EricGend/smart-scale/Dokumentation_Latex/Dateien/Allgemein/Titelseite_Praxisbericht.tex

\newgeometry{left=2.5cm, right=2.5cm, top=2.5cm, bottom=2.5cm}

\begin{titlepage}

\begin{center}


\begin{Large}
	Hochschule für angewandte Wissenschaften Coburg\\
	Fakultät Elektrotechnik und Informatik
	\par
\end{Large}

\vspace{1.5cm}
        
\begin{Large}
	Studiengang: \Studiengang
\par
\end{Large}

\vspace{1.5cm}
        
\begin{Large}
	\Dokumententitel
	
	Betreut durch: \Betreuer
\end{Large}

\vspace{1cm}
        
\begin{huge}
	\Autorenname
\end{huge}

\vspace{1.5cm}   

%\begin{table}[hp]
%	\centering
%	\begin{tabular}{| L{3cm} | L{11cm} |}
%	\hline
%	Unternehmen & \UnternehmenName \\
%	& \UnternehmenAbteilung \\
%	& \UnternehmenStrasse \\
 %	& \UnternehmenOrt \\
%	\hline
%	Zeitraum & \DatumBeginn \ bis \DatumEnde \\
%	\hline
%	\end{tabular}
%\end{table}

\begin{large}
	Abgabe des Berichts: \Abgabedatum
\end{large}

%\begin{table}[hp]
%	\centering
%	\begin{tabular}{| L{3cm} | L{6cm} | L{5cm} |%}
%	\multicolumn{3}{l}{Freigabe zur Vorlage des Praxisberichts an der HS Coburg:} \\
%	\hline
%	Betreuer & \UnternehmenBetreuer & \\
%	\hline
%	Funktion & \BetreuerFunktion & \textbf{\textit{Ort, Datum}}\\
%	\hline
%	Telefon	& \BetreuerTelefon & \\
%	\cline{1-2}
%	email & \BetreuerEmail & \\
%	\hline
 %	& & \textbf{\textit{Unterschrift Betreuer}}\\
%	\hline
%	\end{tabular}
%\end{table}
        
\end{center}
    
\end{titlepage}

\restoregeometry
