EricGend/smart-scale/Dokumentation_Latex/Dateien/Allgemein/ehrenwoertliche_Erklaerung.tex

\section*{Ehrenwörtliche Erklärung}

\begin{verbatim}

\end{verbatim}

Ich versichere hiermit, dass ich meine \Dokumentenart \ selbstständig verfasst, keine anderen als die angegebenen Quellen und Hilfsmittel benutzt, sowie nicht an anderer Stelle als Prüfungsarbeit vorgelegt habe.

\begin{verbatim}

\end{verbatim}

\begin{table*}[hp]
\centering
\begin{tabular}{ L{6cm} L{2cm} L{6cm}}
& & \\
& & \\ \cline{1-1}
Ort &  \\
& & \\
& & \\
& & \\
& &  \\ \cline{1-1} \cline{3-3}
Datum & & Unterschrift \\
\end{tabular}
\end{table*}
