EricGend/smart-scale/Dokumentation_Latex/Dateien/Allgemein/Titelseite.tex

\newgeometry{left=2.5cm, right=2.5cm, top=2.5cm, bottom=2.5cm}

\begin{titlepage}
    \begin{center}
    
        \begin{Large}
        Hochschule für angewandte Wissenschaften Coburg
        \\
        Fakultät Elektrotechnik und Informatik
        \par
        \end{Large}
        \vspace{1.5cm}
        
        \begin{Large}
            Studiengang: \Studiengang
            \par
        \end{Large}
        \vspace{1.5cm}
        
        \begin{Large}
        	\Dokumentenart
        \end{Large}
        \vspace{1cm}
        
        \begin{Huge}
        	\textbf{\Dokumententitel}
        \end{Huge}
        
        \vspace{2cm}
        
        \begin{huge}
        	\Autorenname
        \end{huge}
        \vspace{2cm}
        
        \begin{Large}
        	Abgabe der Arbeit: \Abgabedatum
        \end{Large}
        
        \begin{Large}
        	Betreut durch:
        \end{Large}
        
        \begin{Large}
        	\Betreuer , Hochschule Coburg
        \end{Large}
        
	\end{center}
    
\end{titlepage}

\restoregeometry
