EricGend/smart-scale/Dokumentation_Latex/Dateien/Anhang/ehrenwoertliche_Erklaerung.tex

\begin{centering}
\textbf{{\huge Ehrenwörtliche Erklärung}}
\par
\end{centering}

\vspace{2cm}

Ich versichere hiermit, dass ich meine/n Praxisbericht/Bachelorarbeit/Masterarbeit mit dem Titel

\vspace{2cm}

\begin{tabular*}{\linewidth}{@{\extracolsep{\fill}}ccc}
 \\ \hline
 \vspace{2cm}
 \\ \hline
\end{tabular*}

\vspace{2cm}

selbständig verfasst, keine anderen als die angegebenen Quellen und Hilfsmittel benutzt sowie nicht an anderer Stelle als Prüfungsarbeit vorgelegt habe.

\vfill

\begin{tabular*}{ccc}
\cline{1-1}
\parbox{7cm}{\raggedright Ort} &
\parbox{3cm}{\raggedright} &
\parbox{7cm}{\raggedright} \\
\vspace{2.5cm} \\
\cline{1-1} \cline{3-3}
\parbox{7cm}{\raggedright Datum} &
\parbox{3cm}{\raggedright} &
\parbox{7cm}{\raggedright Unterschrift} \\ 
\end{tabular*}
