EricGend/smart-scale/Dokumentation_Latex/Dateien/Allgemein/Worttrennungen.tex

%hier müssen alle Wörter rein, welche Latex von sich aus nicht korrekt trennt bzw. bei denen man die genaue Trennung vorgeben möchte
\hyphenation{
Film-pro-du-zen-ten
Lux-em-burg
Soft-ware-bau-stein
zeit-in-ten-siv
Ab-kürz-ungs-ver-zeich-nis
}
