EricGend/smart-scale/Dokumentation_Latex/Dateien/Verzeichnisse/Symbolverzeichnis.tex

\nomenclature[01]{\textbf{Symbol}}{\textbf{Bedeutung} \nomunit{\textbf{[phys. Einheit]}}}

% Symbole hier eintragen

\nomenclature{$i$}{ganzzahlige Laufvariable}
\nomenclature{$n$}{Umfang der Messreihe oder Stichprobe}
\nomenclature{$s$}{empirische Standardabweichung
	\nomunit{[\si{\metre}]}}
\nomenclature{$\overline{x}$}{Mittelwert der Stichprobe	
	\nomunit{[\si{\metre}]}}
\nomenclature{$x_i$}{Einzelmesswert
	\nomunit{[\si{\metre}]}}
