EricGend/smart-scale/Arduino/NanoBLE/Platinenlayout_Steckplatine.png

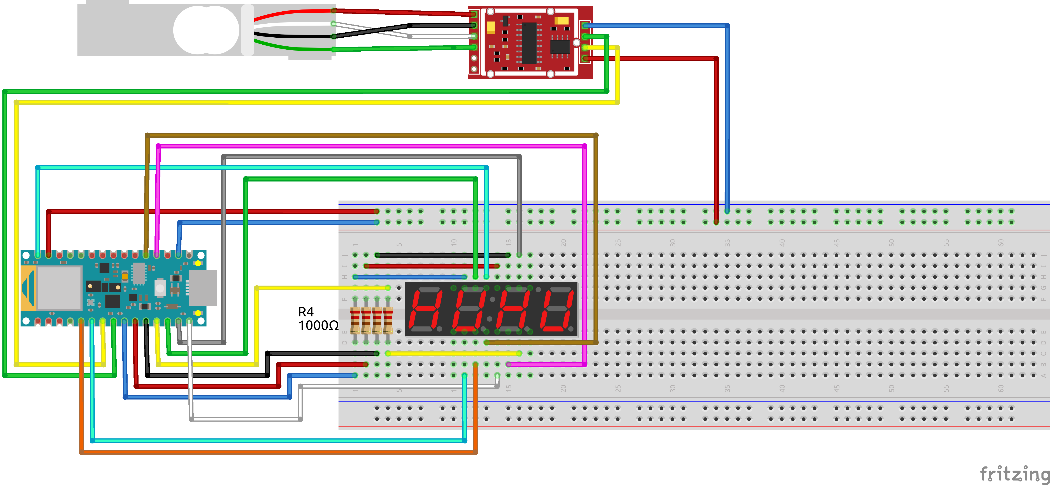
Arduino/NanoBLE/Platinenlayout_Steckplatine.png
