EricGend/smart-scale/3d_Druck/Teller.STL

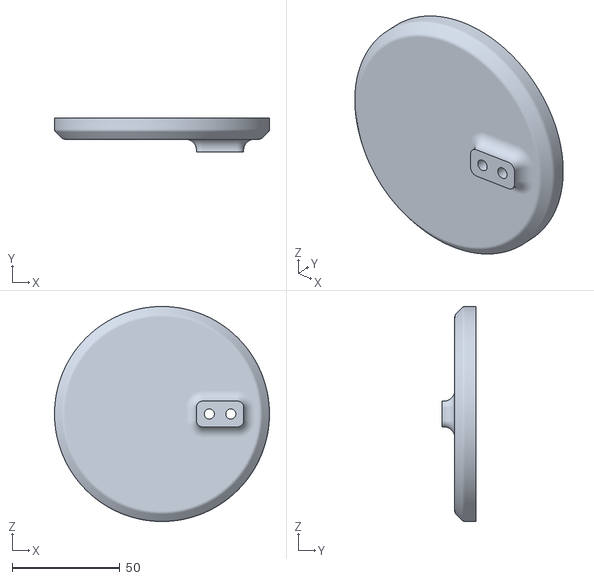
[picture p7: CAD file, 2022-08-14]
3d_Druck/Teller.STL
100.0 x 16.0 x 100.0
