EricGend/smart-scale/Dokumentation_Latex/Bilder/Teller-1.pdf

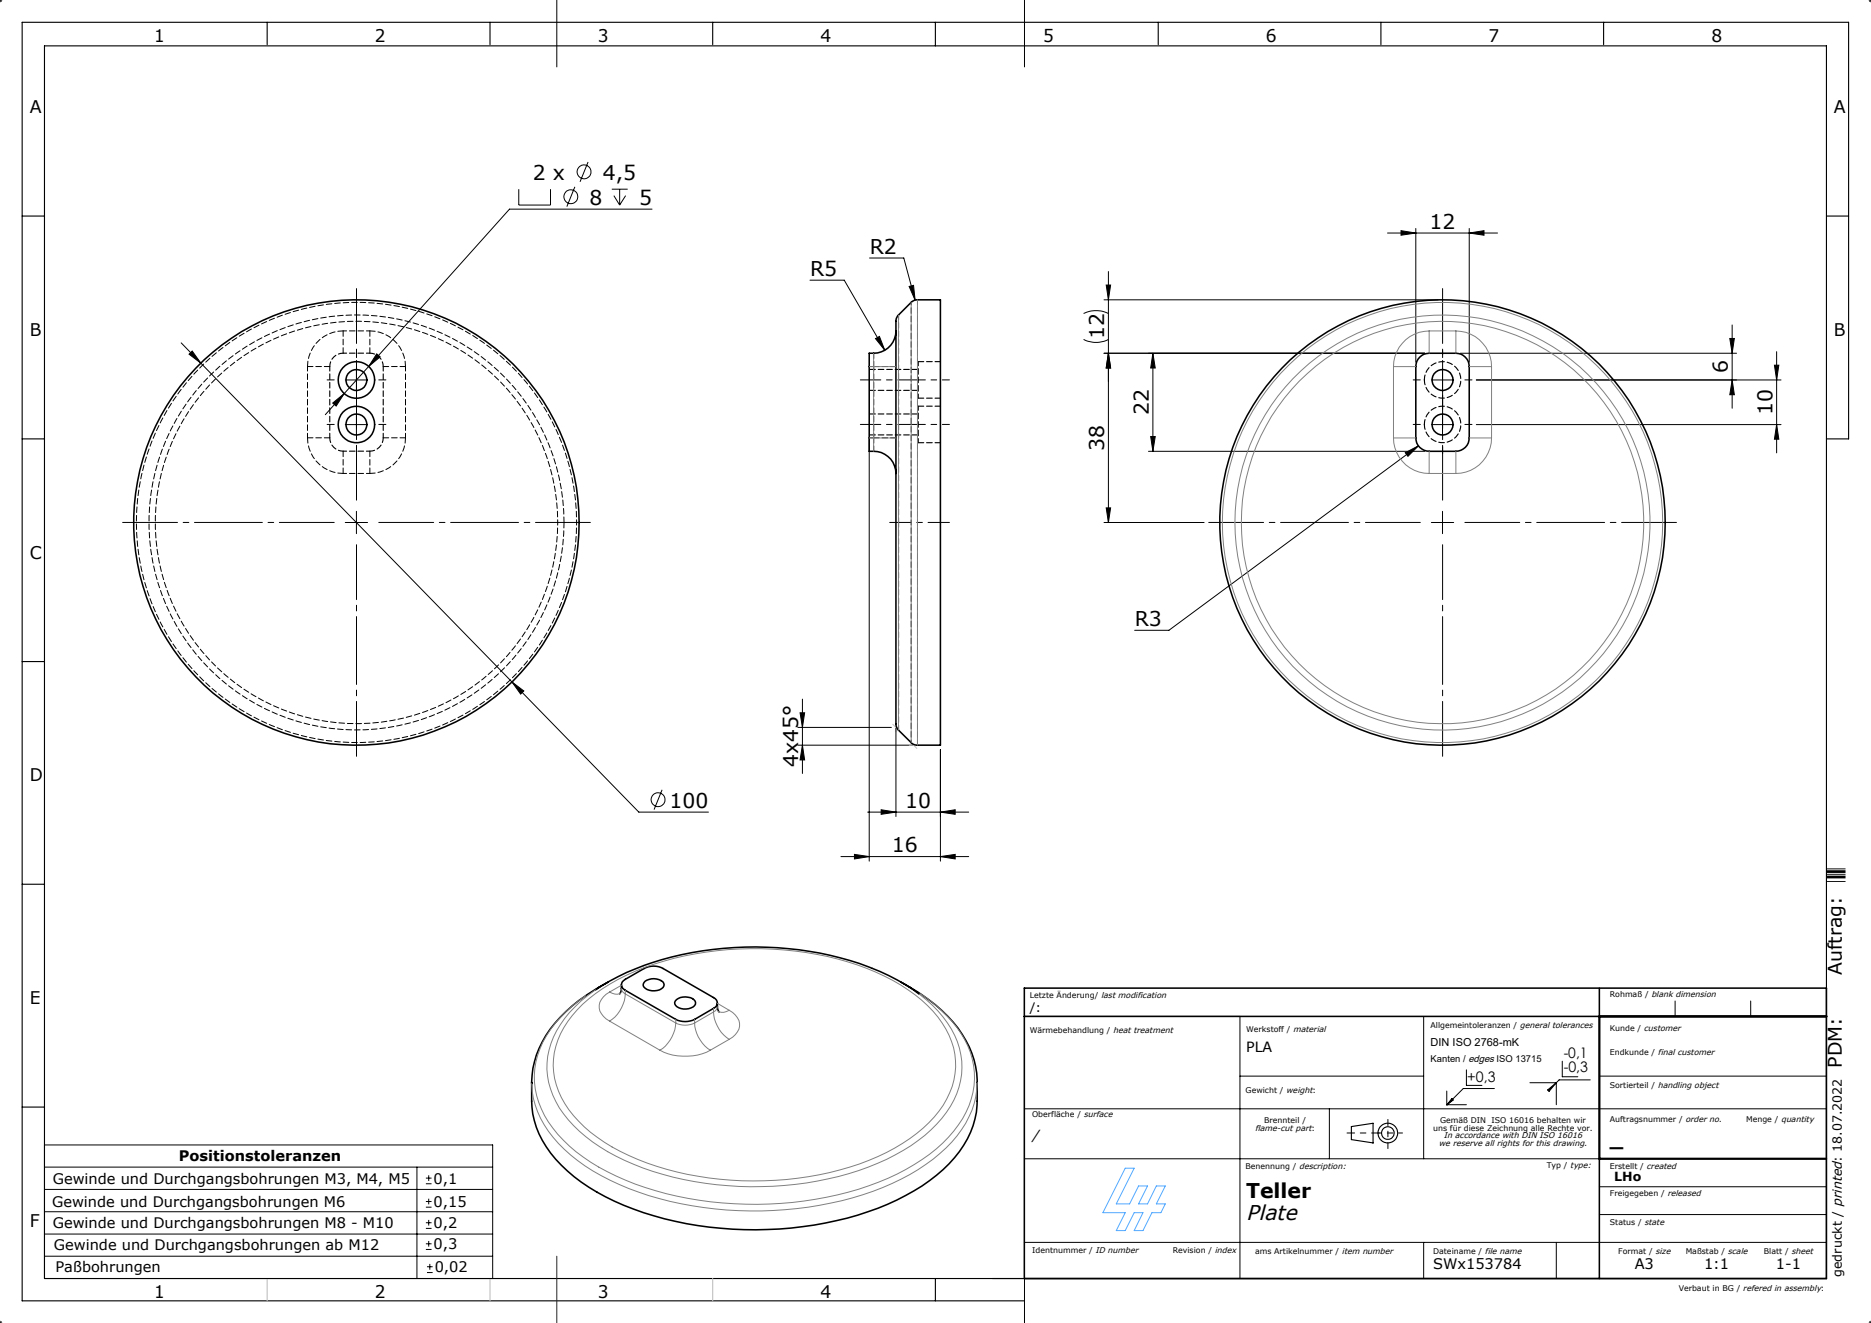
[picture p8: page 1]
Blatt / sheet; Maßstab / scale; Format / size; Erstellt / created; Status / state; Freigegeben / released; Identnummer / ID number; Revision / index

Bgedruckt / printed: 18.07.2022 PDM: Auftrag: _

Letzte Änderung/ last modification /: | Rohmaß / blank dimension

Allgemeintoleranzen / general tolerances Wärmebehandlung / heat treatment Werkstoff / material DIN ISO 2768-mK PLA -0,1 Kanten / edges ISO 13715 -0,3 +0,3 Gewicht / weight: Oberfläche / surface Benennung / description: Typ / type: Teller Plate | Kunde / customer Endkunde / final customer Sortierteil / handling object Auftragsnummer / order no. Menge / quantity _

Brennteil /
flame-cut part:

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

ams Artikelnummer / item number

Dateiname / file name
SWx153784

Verbaut in BG / refered in assembly:
