EricGend/smart-scale/Dokumentation_Latex/Bilder/Platinenlayout.pdf

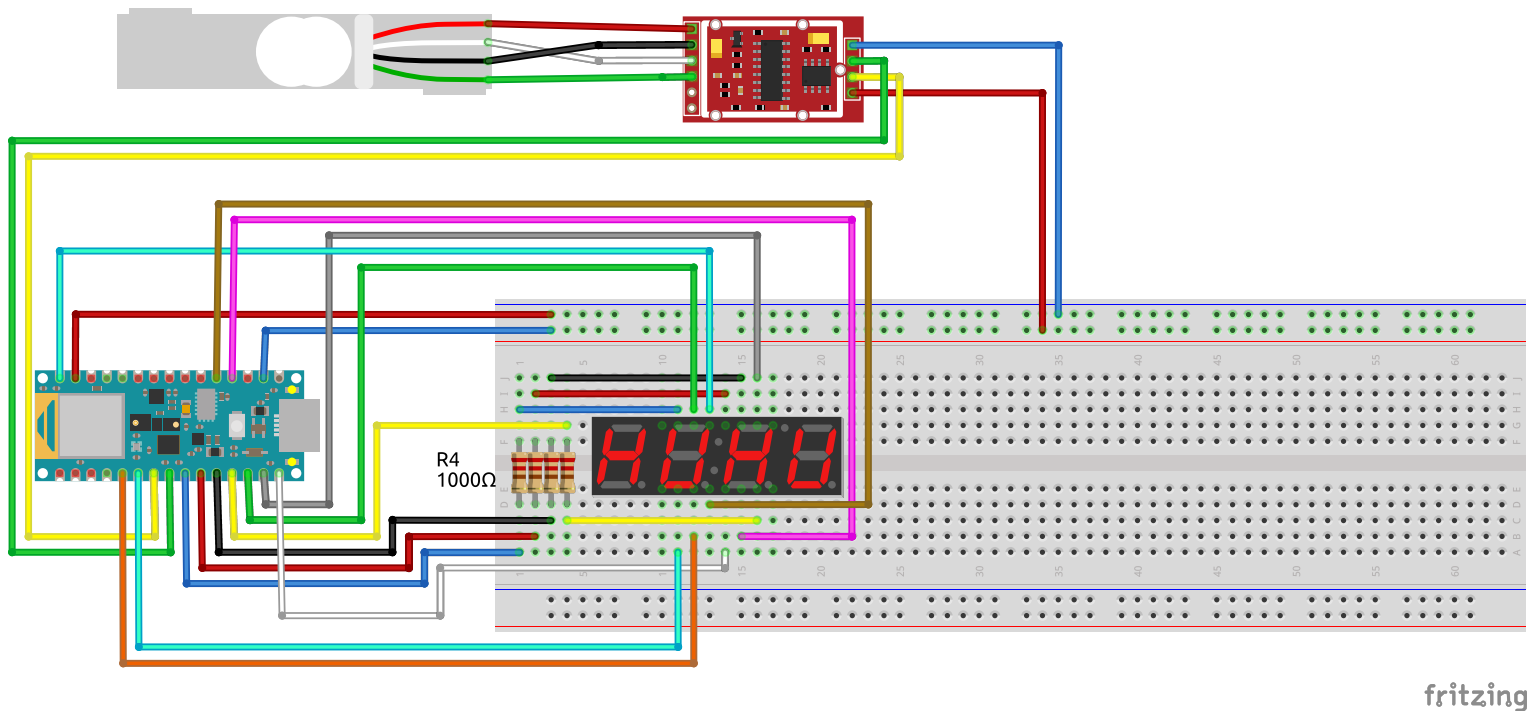
[picture p9: page 1]
