EricGend/smart-scale/(list of files, drawings)

Other design files:
Arduino/NanoBLE/Platinenlayout.fzz
