EricGend/smart-scale/Arduino/Scetches/LED_Taster/Scale_Test/Scale_Test.ino

#include "HX711.h"
// HX711 circuit wiring
const int LOADCELL_DOUT_PIN = 8;
const int LOADCELL_SCK_PIN = 9;
const int Calibration_Weight = 126;
HX711 scale;

void setup() {
  Serial.begin(57600);
  scale.begin(LOADCELL_DOUT_PIN, LOADCELL_SCK_PIN);
  scale.set_scale();
  scale.tare();
  Serial.println("Calibration");
  Serial.println("Put a known weight on the scale");
  delay(5000);
  float x = scale.get_units(10);
  Serial.println(x);
  x = x / Calibration_Weight;
  scale.set_scale(x);
  Serial.println("Calibration finished...");
  delay(3000);
}

void loop() {
  if (scale.is_ready()) {
    float reading = scale.get_units(10);
    Serial.print("HX711 reading: ");
    Serial.println(reading);
  } 
  else {
    Serial.println("HX711 not found.");
  }
  delay(1000);
}
